thijmau/walnut-huller-sorter/mechanical/stl/README.md

# STL

This directory is currently empty, these files will get exported once the
testing and manufacturing process has started.
