thijmau/walnut-huller-sorter/docs/stickers/README.md

# Safety Stickers

Because the machine has multiple moving parts, transports liquids and is powered
by electricity, there are multiple risks involved using it. The function of
these stickers is to warn people (_especially those who've never read the
manual_) of specific hazards and their locations on the machine.

The hazards themselves are extensively described
in [the safety manual](../manuals/safety-manual.md), which should be read before
using and/or building the machine. The symbols are based
on [ISO 7010](https://en.wikipedia.org/wiki/ISO_7010) to make them widely
recognizable and consistent with the international standard.

Below is a table which summarizes the stickers that are recommended to be placed
on the machine, with their respective location and meaning.

| Sticker | ISO 7010 | Location | Source |
|---|---|---|---|
| ⚠️ Rotating blades | [W088](ISO_7010_W088.svg) | Fan box | [Wikimedia Commons](https://commons.wikimedia.org/wiki/File:ISO_7010_W088.svg) |
| ⚠️ Crushing of hands | [W024](ISO_7010_W024.svg) | Rollers, belt | [Wikimedia Commons](https://commons.wikimedia.org/wiki/File:ISO_7010_W024.svg) |
| ⚠️ Electricity/electrocution | [W012](ISO_7010_W012.svg) | Electrical enclosure | [Wikimedia Commons](https://commons.wikimedia.org/wiki/File:ISO_7010_W012.svg) |
| 🚫 Do not spray with water | [P016](ISO_7010_P016.svg) | Electrical enclosure | [Wikimedia Commons](https://commons.wikimedia.org/wiki/File:ISO_7010_P016.svg) |
| 🚫 No drinking water | [P005](ISO_7010_P005.svg) | Water inlet on the machine | [Wikimedia Commons](https://commons.wikimedia.org/wiki/File:ISO_7010_P005.svg) |
| ℹ️  Disconnect before maintenance | [M021](ISO_7010_M021.svg) | Operator panel | [Wikimedia Commons](https://commons.wikimedia.org/wiki/File:ISO_7010_M021.svg) |
| ℹ️  Read the instructions | [M002](ISO_7010_M002.svg) | Operator panel | [Wikimedia Commons](https://commons.wikimedia.org/wiki/File:ISO_7010_M002.svg) |
| ℹ️  Wear safety gloves | [M009](ISO_7010_M009.svg) | Operator panel | [Wikimedia Commons](https://commons.wikimedia.org/wiki/File:ISO_7010_M009.svg) |
| ℹ️  Wear hearing protection | [M003](ISO_7010_M003.svg) | Operator panel | [Wikimedia Commons](https://commons.wikimedia.org/wiki/File:ISO_7010_M003.svg) |

<sub>These stickers are
not licensed nor owned by this project and all rights belong to their respective
owners, see each corresponding source page to view its license.</sub>
