thijmau/walnut-huller-sorter/mechanical/fabrication/abrasive-drum_sheetmetal.dxf

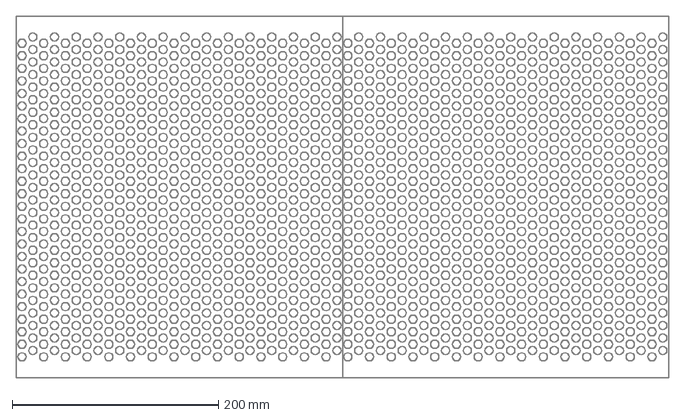
[picture p1: CAD file, 2026-10-23]
mechanical/fabrication/abrasive-drum_sheetmetal.dxf
632.4 x 350.0 mm
