thijmau/walnut-huller-sorter/mechanical/fabrication/abrasive-drum-flange_sheetmetal.dxf

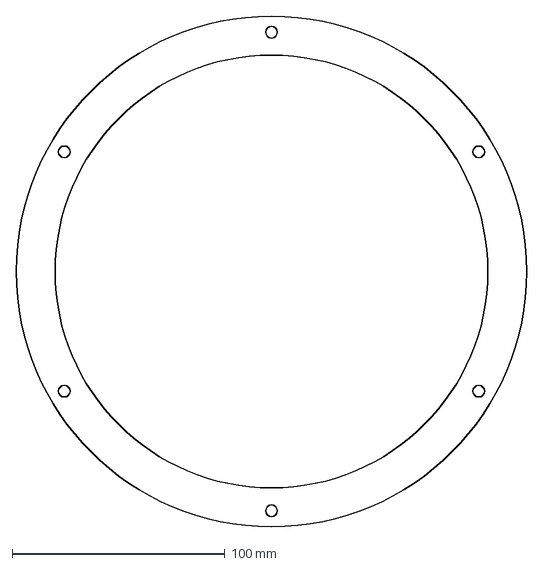
[picture p2: CAD file, 2026-10-23]
mechanical/fabrication/abrasive-drum-flange_sheetmetal.dxf
240.0 x 240.0 mm
