thijmau/walnut-huller-sorter/(list of files, cad)

Other CAD files:
mechanical/cad/Walnut Hulling & Sorting Machine.f3z
mechanical/cad/abrasive-drum.f3d
