thijmau/walnut-huller-sorter/(commit log)

2026-10-22 chore: initial commit
    This commits adds the initial files of the Walnut Huller & Sorter Machine
    project. It sets up the expected project structure and the most important
    initial files for building the device.
    - README added to give the reader an initial view of the project idea
    - Safety manual added to make users aware of the risks involved
    - ISO7010 stickers added to make it easy to show information about the machine
    [bom.csv]
2026-10-23 feature: add abrasive drum design and source files
    This commit adds the design decisions, calculations and source files
    for the abrasive drum. For example, the dimenions, volume, inspiration
    and studies determining the current iteration.
    [abrasive-drum-flange_sheetmetal.dxf, abrasive-drum.f3d, abrasive-drum_sheetmetal.dxf]
2026-10-23 docs: add information about the perforation holes
2026-10-24 feature: design drum endcaps, rollers, hopper and overflow catcher - #2
    The drum could not work as a standalone tube: it needs closed ends to keep unhulled walnuts inside, a way to be driven, a way to rotate while angled, and controlled paths for walnuts to enter and leave. This adds the design documents for those missing parts so the assembly can be evaluated and fabricated as a whole.
    Add endcap designs. The entry endcap provides the hopper opening and a swappable pulley for driving the drum; the exit endcap only lets walnuts through once they are small enough. Both bolt to the existing drum flange and double as the rolling surface, avoiding a separate fabricated steel ring.
    Add t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
    [Walnut Hulling & Sorting Machine.f3z]
2026-10-25 fix(drum): adjust overflow catcher and hopper sizing
    - overflow-catcher: reduce holes from 4 to 3 to allow for a smaller mount (it is the primary mount, but its light weight means it doesn't need a large mounting pattern)
    - overflow-catcher: switch from countersunk to button head fastener holes to maintain adequate wall thickness
    - hopper: downsize based on a more accurate Juglans regia reference (ripe walnuts shrink significantly before falling off; previous sizing aligned more closely with Juglans nigra)
    - docs: fix various spelling mistakes
    [Walnut Hulling & Sorting Machine.f3z]
2026-10-25 docs(drum): add Interwheel 40x14 guide rollers (6x) with M8 mounting notes
    [bom.csv]
2026-10-27 feat(drum): change exit endcap to gate-style instead of circular
    This change has been made because the angle on the circle outlet
    was not steep enough to let walnuts out easily, this new outlet
    is more in line with the shape of the metal tube and is an
    improvement to preventhing pile-ups.
2026-10-27 feat(drum): change roller mounting from recess to tabs
    This change was made because the recess mount would most likely
    trap a lot of water due to it's environment, and it also (in my
    opinion) looks worse than just two tabs. Especially if you get
    drainage holes involved in the earlier design. It's also simpler
    to mount this way, as you can just basically use any bolt-washer
    combination that you like, instead of being forced to use countersunk.
    [Walnut Hulling & Sorting Machine.f3z]
